elemental-platform/element-e300/README.md

# element-e300
Wireless carbon dioxide sensor based on RFM69 radio

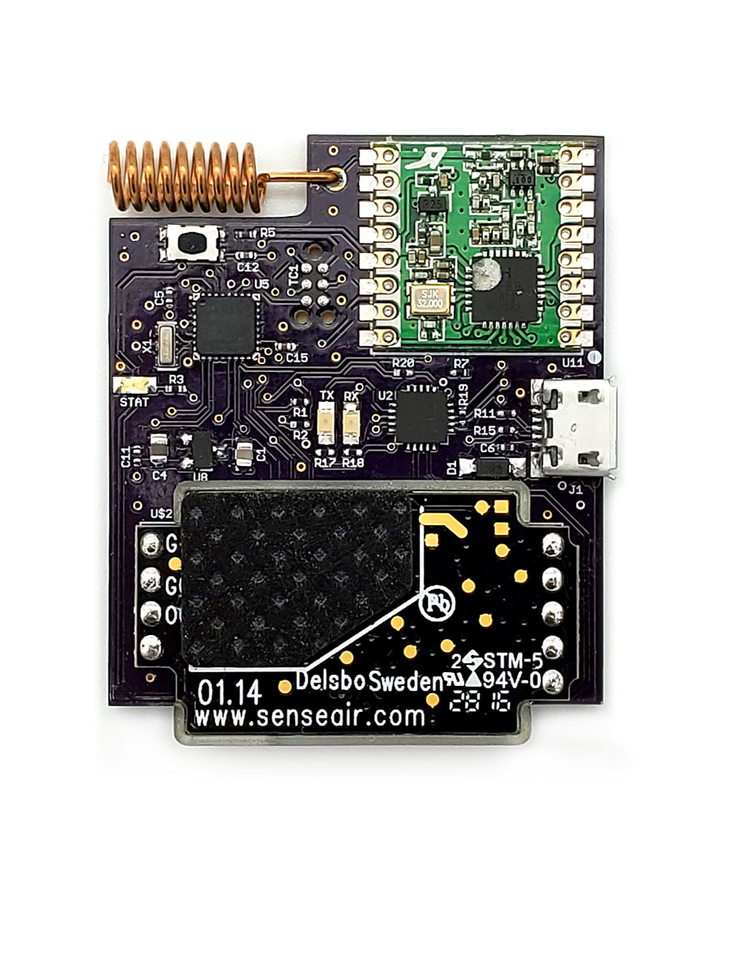
[picture p1: E300.jpg]
element e300
