elemental-platform/element-e300/hardware/E300.brd

## EAGLE design hardware/E300.brd (2019-09-02)

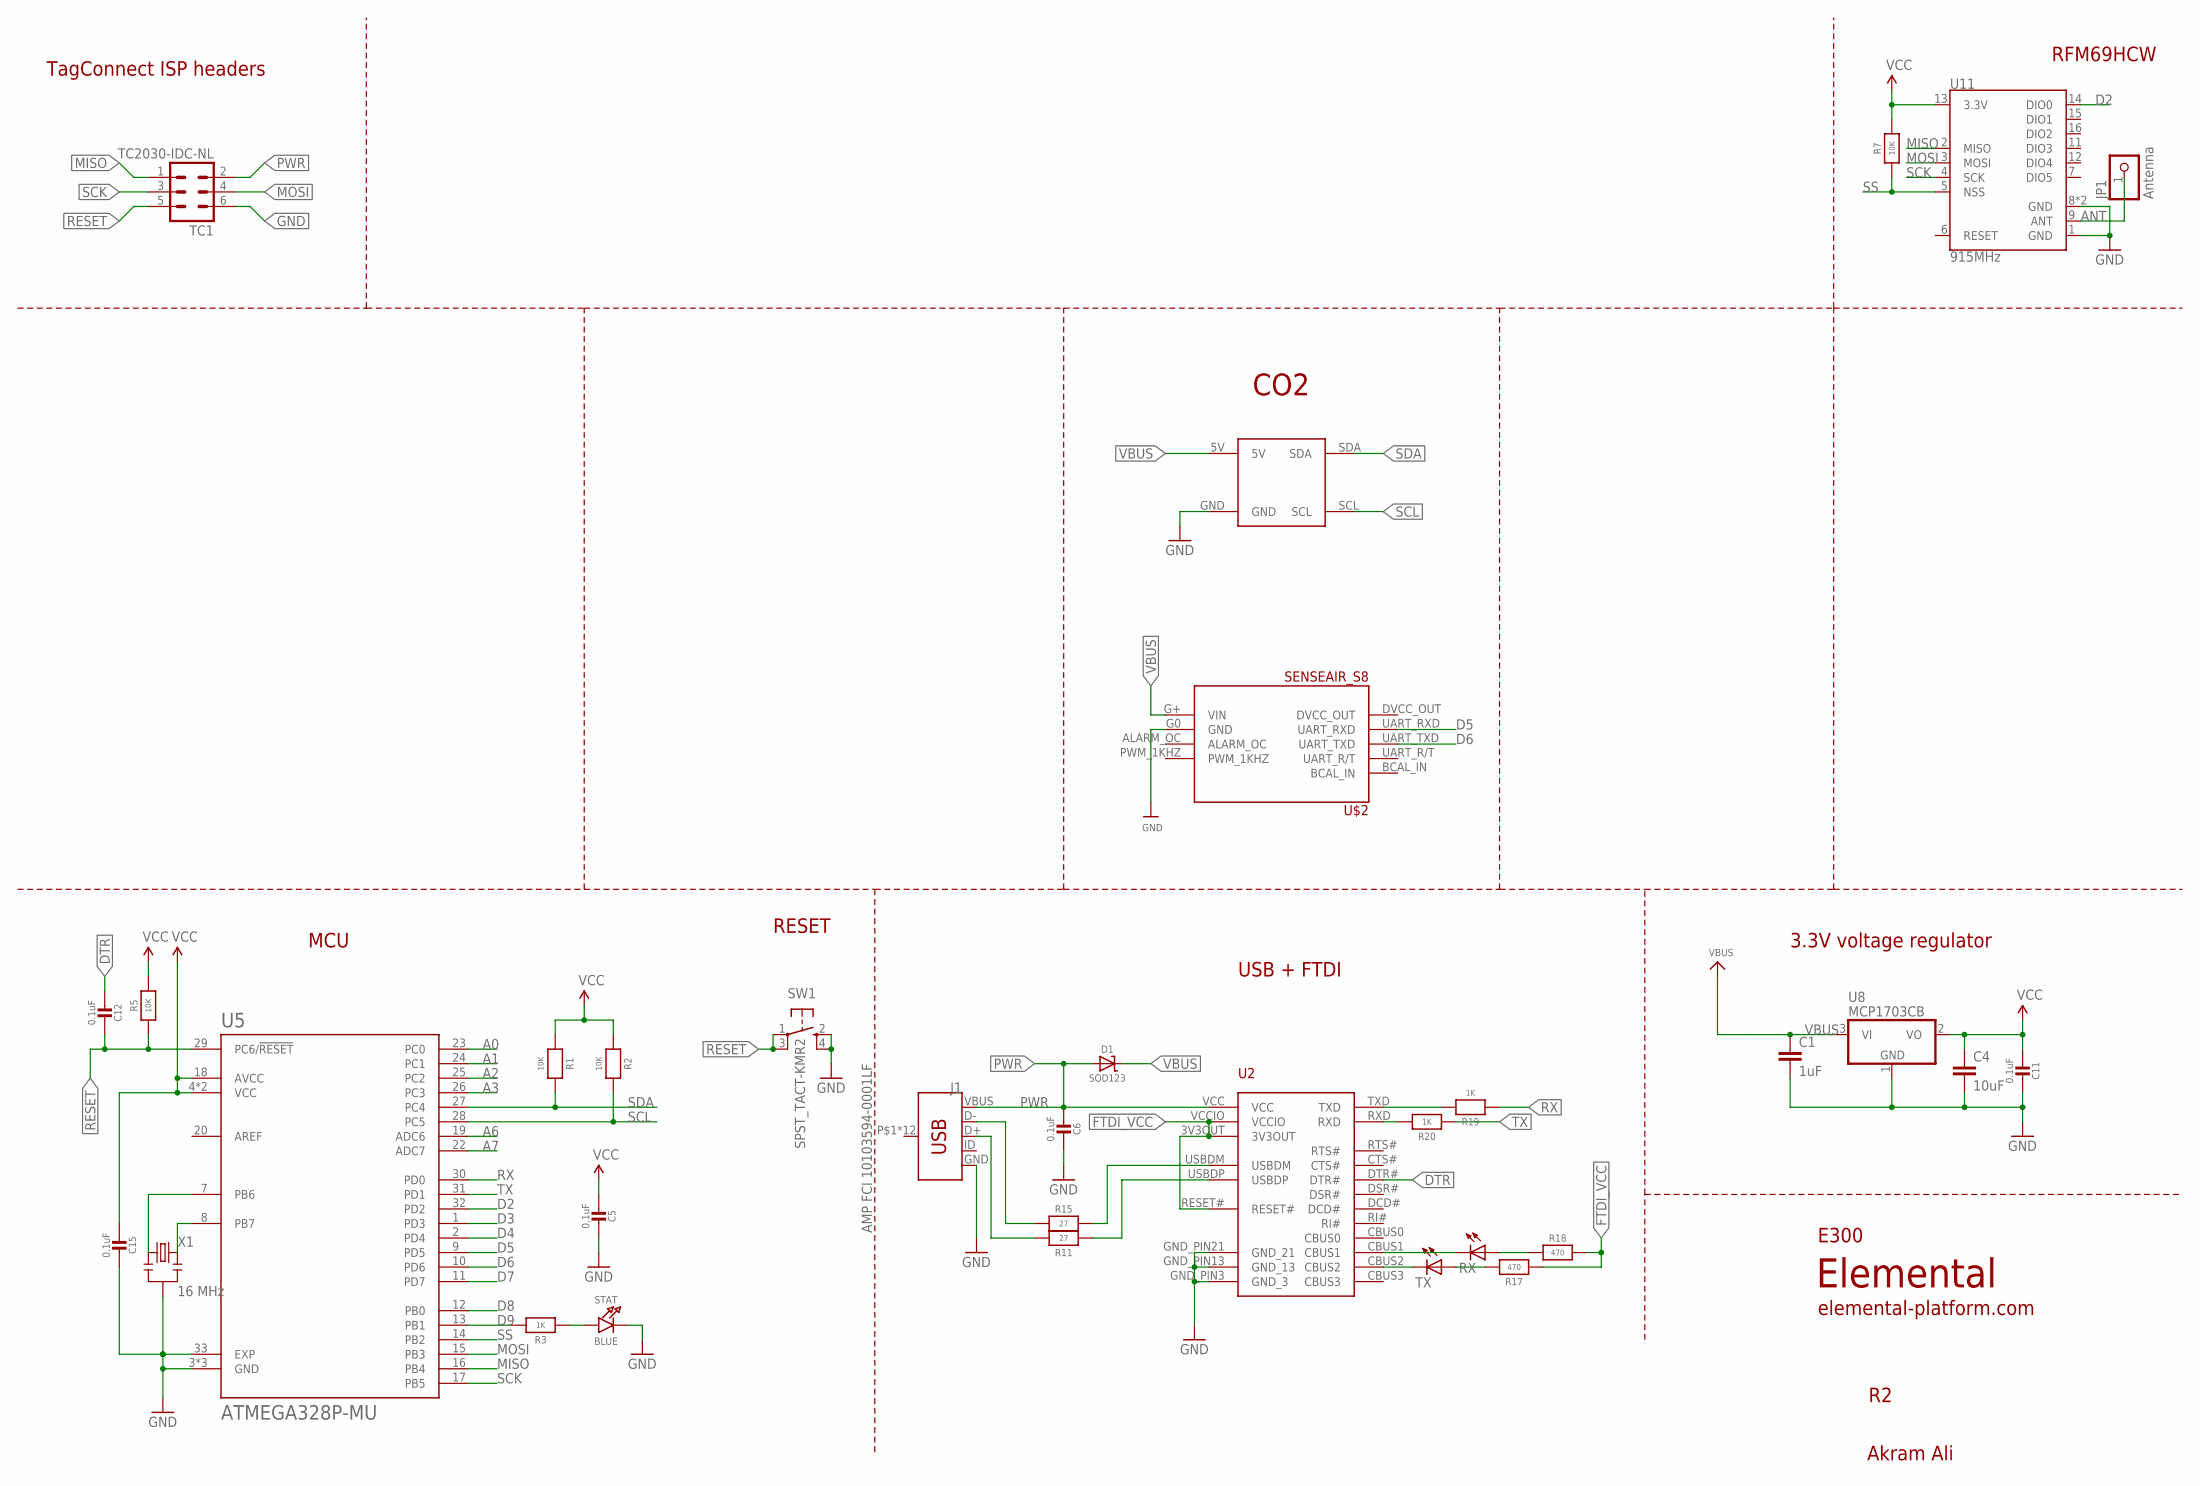
[picture p2: schematic E300.sch]

Parts:
C1: 1uF; 0805; MPN CC0805ZRY5V8BB105
C4: 10uF; 0805; MPN CC0805KKX5R6BB106
C5, C6, C11, C12, C15: 0.1uF; MICROBUILDER__0402MP; MPN GRM155R71C104KA88J
D1: SOD123; MICROBUILDER_SOD-123; MPN SD103AW-13-F
J1: AMP FCI 10103594-0001LF; USB-MICROB-PTH
JP1: Antenna; 1X01-CLEANBIG; MPN Helical antenna
R1, R2: 10K; MICROBUILDER__0402MP; MPN RC0402JR-071KL
R3: 1K; MICROBUILDER__0402MP; MPN RC0402JR-0710KL
R5, R7: 10K; MICROBUILDER__0402MP; MPN RC0402JR-0710KL
R11, R15: 27; MICROBUILDER__0402MP; MPN RC0402JR-0727RL
R17, R18: 470; MICROBUILDER__0402MP; MPN RC0402JR-07470RL
R19, R20: 1K; MICROBUILDER__0402MP; MPN RC0402JR-071KL
RX: LEDCHIPLED_0805; CHIPLED_0805; MPN LG R971-KN-1
STAT: BLUE; CHIPLED_0805_NOOUTLINE
SW1: SPST_TACT-KMR2; KMR2
TC1: TC2030-IDC-NL
TX: LEDCHIPLED_0805; CHIPLED_0805; MPN LG R971-KN-1
U2: FT231XQ-R; FTDI_FT231XQ-R_PACKAGE; MPN FT231XQ-R
U5: ATMEGA328P-MU; QFN50P500X500X100-33N; MPN ATMEGA328P-MU
U6: K30-CO2-I2C
U8: MCP1703CB; SOT23; MPN MCP1703T-3302E/CB
U11: 915MHz; RFM69HCW-XXXS2; MPN RFM69HCW
U$2: SENSEAIR_S8
X1: 16 MHz; RESONATOR-SMD; MPN CSTCE16M0V53-R0

Connections:
A0: U5.23 (PC0)
A1: U5.24 (PC1)
A2: U5.25 (PC2)
A3: U5.26 (PC3)
A6: U5.19 (ADC6)
A7: U5.22 (ADC7)
ANT: JP1.1, U11.9 (ANT)
D2: U5.32 (PD2), U11.14 (DIO0)
D3: U5.1 (PD3)
D4: U5.2 (PD4)
D5: U5.9 (PD5), U$2.UART_RXD
D6: U5.10 (PD6), U$2.UART_TXD
D7: U5.11 (PD7)
D8: U5.12 (PB0)
D9: R3.2, U5.13 (PB1)
DTR: C12.2, U2.DTR#
FTDI_VCC: R17.1, R18.2, U2.3V3OUT, U2.RESET#, U2.VCCIO
GND: C1.2, C4.2, C5.1, C6.1, C11.1, C15.1, J1.GND, STAT.C, SW1.2 (S), SW1.4 (S1), TC1.6, U2.GND_PIN3 (GND_3), U2.GND_PIN13 (GND_13), U2.GND_PIN21 (GND_21), U5.3 (GND), U5.5 (GND), U5.21 (GND), U5.33 (EXP), U6.GND, U8.1 (GND), U11.1 (GND), U11.8 (GND), U11.10 (GND), U$2.G0 (GND), X1.2
MISO: TC1.1, U5.16 (PB4), U11.2 (MISO)
MOSI: TC1.4, U5.15 (PB3), U11.3 (MOSI)
unnamed: R20.2, U2.RXD
unnamed: R19.2, U2.TXD
unnamed: U5.8 (PB7), X1.3
unnamed: U5.7 (PB6), X1.1
unnamed: R3.1, STAT.A
unnamed: RX.C, U2.CBUS1
unnamed: TX.C, U2.CBUS2
unnamed: R15.2, U2.USBDM
unnamed: R11.1, U2.USBDP
unnamed: R18.1, RX.A
unnamed: R17.2, TX.A
unnamed: J1.D-, R15.1
unnamed: J1.D+, R11.2
PWR: C6.2, D1.A, J1.VBUS, TC1.2, U2.VCC
RESET: C12.1, R5.1, SW1.1, SW1.3 (P1), TC1.5, U5.29 (PC6/!RESET)
RX: R19.1, U5.30 (PD0)
SCK: TC1.3, U5.17 (PB5), U11.4 (SCK)
SCL: R2.2, U5.28 (PC5), U6.SCL
SDA: R1.2, U5.27 (PC4), U6.SDA
SS: R7.1, U5.14 (PB2), U11.5 (NSS)
TX: R20.1, U5.31 (PD1)
VBUS: C1.1, D1.C, U6.5V, U8.3 (VI), U$2.G+ (VIN)
VCC: C4.1, C5.2, C11.2, C15.2, R1.1, R2.1, R5.2, R7.2, U5.4 (VCC), U5.6 (VCC), U5.18 (AVCC), U8.2 (VO), U11.13 (3.3V)

Notes on the sheet:
TagConnect ISP headers
3.3V voltage regulator
Elemental
E300
Akram Ali
USB + FTDI
elemental-platform.com
RFM69HCW
MCU
RESET
CO2

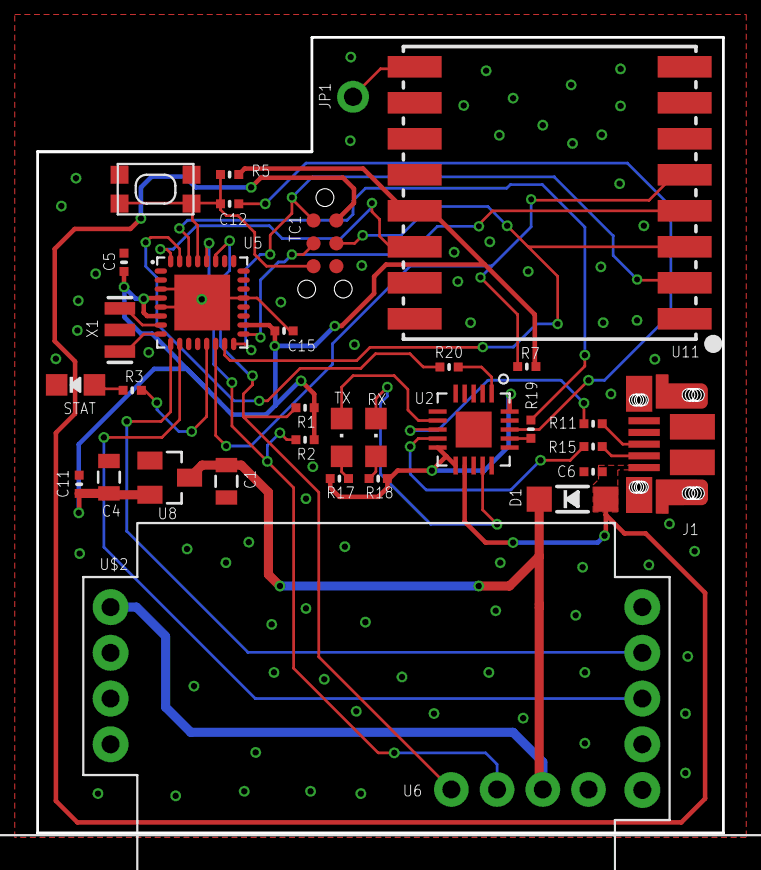
[picture p3: board E300.brd from above]

Board: 2 copper layers, 38.1 x 44.2 mm, 33 parts (0 on the bottom side), 33 nets.
