elemental-platform/element-e300/firmware/firmware.ino

//*****************************************************************************************************************************
// Element E300 v1.3 firmware

// Developed by AKstudios
// Updated: 02/04/2020

//*****************************************************************************************************************************
// libraries in use

#include <RFM69.h>  //  https://github.com/LowPowerLab/RFM69
#include <SPI.h>
#include <Arduino.h>
#include <Wire.h> 
#include <SoftwareSerial.h>
#include <avr/sleep.h>
#include <avr/wdt.h>

//*****************************************************************************************************************************
// configurable global variables - define node parameters

#define NODEID              23  // must be unique for each node on same network (supports 10bit addresses (up to 1023 node IDs))
#define NETWORKID           20
#define CONTROLNODE_ID      20
#define GATEWAYID           1
#define GATEWAY_NETWORKID   1
#define FREQUENCY           RF69_915MHZ //Match this with the version of your Moteino! (others: RF69_433MHZ, RF69_868MHZ)
#define ENCRYPTKEY          "RgUjXn2r5u8x/A?D" //has to be same 16 characters/bytes on all nodes, not more not less!
#define FREQUENCY_EXACT     905000000   // change the frequency in areas of interference (default: 915MHz)
#define IS_RFM69HW          //uncomment only for RFM69HW! Leave out if you have RFM69W!
#define LED                 9 // led pin
#define POWER               4
#define HAS_CONTROL_NODE    //uncomment only if a control node is present


// other global objects and variables
RFM69 radio;
SoftwareSerial mySerial(6, 5); // RX, TX
byte readCO2[] = {0xFE, 0X44, 0X00, 0X08, 0X02, 0X9F, 0X25};
byte response[] = {0,0,0,0,0,0,0}; //create an array to store the response
char dataPacket[150];
int wake_interval = 0;

//*****************************************************************************************************************************
// Interrupt Service Routine for WatchDog Timer

ISR(WDT_vect) 
{
  wdt_disable();  // disable watchdog
}

//*****************************************************************************************************************************

void setup()
{
  pinMode(10, OUTPUT); // Radio SS pin set as output

  Serial.begin(115200);

  pinMode(POWER, OUTPUT);
  pinMode(LED, OUTPUT);  // pin 9 controls LED
  
  mySerial.begin(9600);
  
  radio.initialize(FREQUENCY,NODEID,GATEWAY_NETWORKID);
  radio.encrypt(ENCRYPTKEY);
#ifdef IS_RFM69HW
  radio.setHighPower(); //uncomment only for RFM69HW!
#endif
#ifdef FREQUENCY_EXACT
  radio.setFrequency(FREQUENCY_EXACT); //set frequency to some custom frequency
#endif

  fadeLED(LED);
}

//*****************************************************************************************************************************
// this function puts the node to sleep with watch dog timer enabled

void sleep()
{
  Serial.flush(); // empty the send buffer, before continue with; going to sleep
  radio.sleep();
  digitalWrite(POWER, LOW);
  delayMicroseconds(100);
  
  cli();          // stop interrupts
  MCUSR = 0;
  WDTCSR  = (1<<WDCE | 1<<WDE);     // watchdog change enable
  WDTCSR  = 1<<WDIE | (1<<WDP3) | (0<<WDP2) | (0<<WDP1) | (1<<WDP0); // set  prescaler to 8 second
  sei();  // enable global interrupts

  byte _ADCSRA = ADCSRA;  // save ADC state
  ADCSRA &= ~(1 << ADEN);

  asm("wdr");
  set_sleep_mode(SLEEP_MODE_PWR_DOWN);
  cli();       

  sleep_enable();  
  //sleep_bod_disable();
  sei();       
  sleep_cpu();   
    
  sleep_disable();   
  sei();  

  ADCSRA = _ADCSRA; // restore ADC state (enable ADC)
  //delay(1);
}

//*****************************************************************************************************************************

void loop() 
{
  sleep(); 
  
  if(wake_interval == 4)    // if enough time has passed (~54 seconds), take measurements and transmit
  {
    readSensors();
    
// send datapacket
    radio.send(GATEWAYID, dataPacket, strlen(dataPacket));
#ifdef HAS_CONTROL_NODE
    sleep();   // sleep 8 seconds before sending data to control node
    radio.setNetwork(NETWORKID);
    radio.sendWithRetry(CONTROLNODE_ID, dataPacket, strlen(dataPacket));  // send data
    radio.setNetwork(GATEWAY_NETWORKID);
#endif

    Serial.println(dataPacket);
    blinkLED(LED, 3);
    
    memset(dataPacket, 0, sizeof dataPacket);   // clear array
    wake_interval = 0;    // reset wake interval to 0
  }
  else
    wake_interval++;    // increment no. of times node wakes up
}

//*****************************************************************************************************************************
// This function reads all sensors and creates a datapacket to transmit

void readSensors()
{
  while(!mySerial.available()) //keep sending request until we start to get a response
  {
   mySerial.write(readCO2, 7);
   delay(10);
  }
  
  int timeout=0; //set a timeout counter
  while(mySerial.available() < 7 ) //Wait to get a 7 byte response
  {
   timeout++;
   if(timeout > 10) //if it takes too long there was probably an error
   {
     while(mySerial.available()) //flush whatever we have
     mySerial.read();
     break; //exit and try again
   }
   delay(50);
  }
  
  for (int i=0; i < 7; i++)
  {
    response[i] = mySerial.read();
  }

  int high = response[3]; //high byte for value is 4th byte in packet in the packet
  int low = response[4]; //low byte for value is 5th byte in the packet
  unsigned long val = high*256 + low; //Combine high byte and low byte with this formula to get value
  
  // define character arrays for all variables
  char _c[7];
  
  // convert all flaoting point and integer variables into character arrays
  dtostrf(val, 1, 0, _c); 
  
  dataPacket[0] = 0;  // first value of dataPacket should be a 0
  
  // create datapacket by combining all character arrays into a large character array
  strcat(dataPacket, "c:");
  strcat(dataPacket, _c);
  delay(1);
}

//*****************************************************************************************************************************
// Fade LED

void fadeLED(int pin)
{
  int brightness = 0;
  int fadeAmount = 5;
  for(int i=0; i<510; i=i+5)  // 255 is max analog value, 255 * 2 = 510
  {
    analogWrite(pin, brightness);  // pin 9 is LED
  
    // change the brightness for next time through the loop:
    brightness = brightness + fadeAmount;  // increment brightness level by 5 each time (0 is lowest, 255 is highest)
  
    // reverse the direction of the fading at the ends of the fade:
    if (brightness <= 0 || brightness >= 255)
    {
      fadeAmount = -fadeAmount;
    }
    // wait for 20-30 milliseconds to see the dimming effect
    delay(10);
  }
  digitalWrite(pin, LOW); // switch LED off at the end of fade
}

//*****************************************************************************************************************************
// blink LED

void blinkLED(int pin, int blinkDelay)
{
  digitalWrite(pin, HIGH);
  delay(blinkDelay);
  digitalWrite(pin, LOW);
}

//*****************************************************************************************************************************
// bruh
